Agroecology-Lab/Open_drive/bldc_motor_cntroller/images/Screenshot From 2026-01-03 15-03-06.png

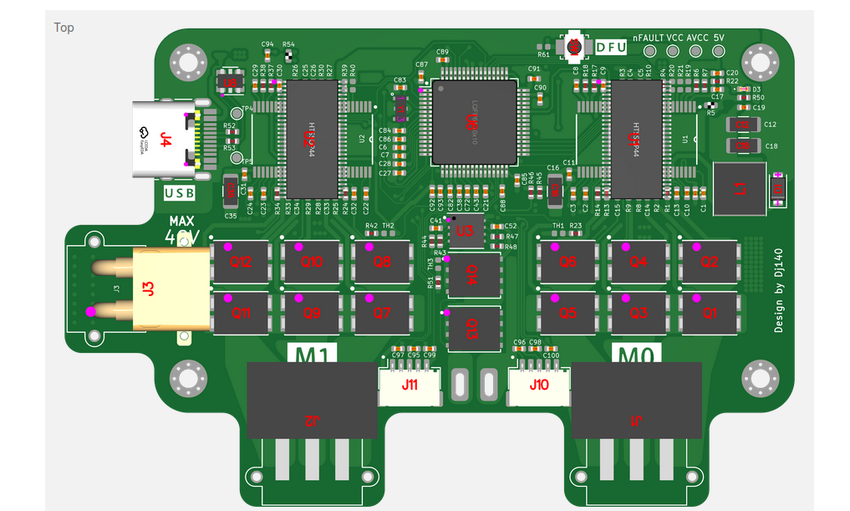
bldc_motor_cntroller/images/Screenshot From 2026-01-03 15-03-06.png
