Agroecology-Lab/Open_drive/bldc_motor_cntroller/images/Screenshot From 2026-10-24 23-25-10.png

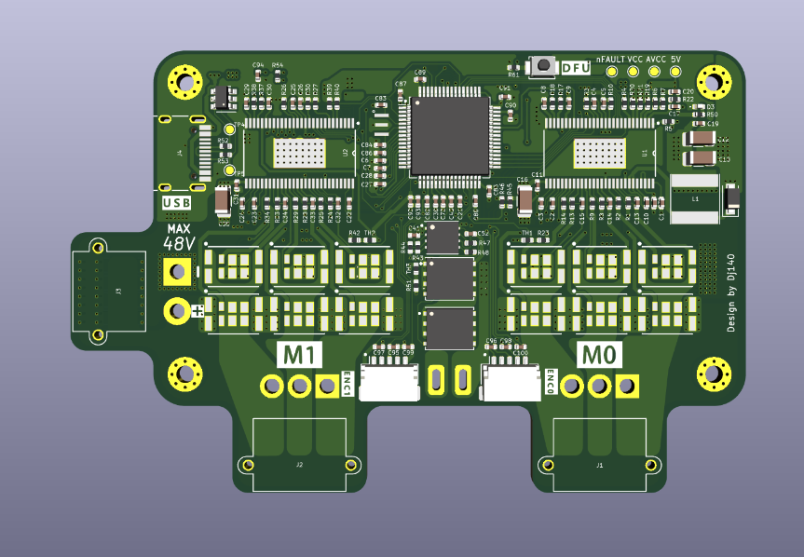
bldc_motor_cntroller/images/Screenshot From 2026-10-24 23-25-10.png
