Agroecology-Lab/Open_drive/bldc_motor_cntroller/production/Screenshot From 2026-01-03 14-52-30.png

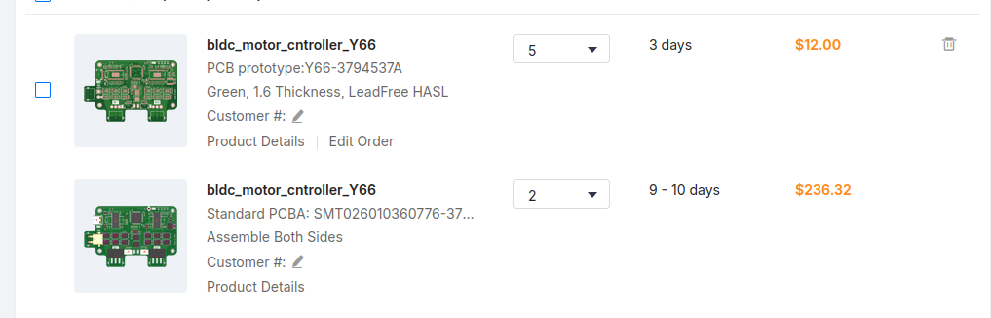
bldc_motor_cntroller/production/Screenshot From 2026-01-03 14-52-30.png
