Agroecology-Lab/Open_drive/bldc_motor_cntroller/production/bom_42v.csv

Comment | Designator | Footprint | LCSC Part #
15nF50V | C1,C22 | 0402 | C114405
2.2nF50V | C2,C3,C6,C7,C23,C24,C27,C28 | 0402 | C1531
22nF50V | C4,C25 | 0402 | C1532
2.2uF25VX5R | C5,C21,C26,C38,C41 | 0402 | C307418
1uF25V | C8,C9,C19,C29,C30,C49,C50,C58,C59,C93 | 0402 | C52923
100nF50V | C10,C13,C14,C15,C32,C33,C34,C52,C82,C85,C87,C89,C91,C92,C94,C95,C96,C97,C98,C99,C100 | 0402 | C131394
100nF100V | C11,C31,C36,C78,C79,C80,C81 | 0402 | C162178
47uF25VX5R | C12,C18 | 1206 | C76659
4.7uF100VX7R | C16,C35,C39,C40,C42,C44,C45,C46,C47,C48,C51,C53,C54,C55,C56,C57,C60,C61,C64,C65,C66,C67,C68,C69,C70,C71,C73,C74,C75,C76,C77 | 1206 | C22367839
82pF50VC0G | C17 | 0402 | C45501
270pF50V | C20,C43 | 0402 | C541471
0.1uF16V | C62,C63 | 0402 | C141382
2.2uF16VX5R | C72,C88,C90 | 0402 | C170151
12pF | C83,C84 | 0402 | C555399
100nF16V | C86 | 0402 | C60474
100V2ASMB | D1,D2 | D_SOD-123F | C705302
GREEN | D3 | 0402 | C74338
MBR2H100SFT3G | D4 | D_SOD-123F | C16197290
Fuse_500MA | F1 | 1206 | C2984676
MR30PW-M15A(30A) | J1,J2 | AMASS_MR30PW-M_1x03_P3.50mm_Horizontal | C19268034
XT30 | J3 | AMASS_XT30PW-M_1x02_P2.50mm_Horizontal | C431092
USB_C_Receptacle_USB2.0 | J4 | USB_C_Receptacle_HRO_TYPE-C-31-M-12 | C165948
Conn_01x03 | J5 | JST_SH_SM03B-SRSS-TB_1x03-1MP_P1.00mm_Horizontal | C5372879
Conn_01x06 | J6 | JST_SH_SM06B-SRSS-TB_1x06-1MP_P1.00mm_Horizontal | C160405
Conn_01x02 | J7,J8 | JST_SH_SM02B-SRSS-TB_1x02-1MP_P1.00mm_Horizontal | C160402
Conn_01x04 | J9 | JST_SH_SM04B-SRSS-TB_1x04-1MP_P1.00mm_Horizontal | C160404
Conn_01x05 | J10,J11 | JST_SH_SM05B-SRSS-TB_1x05-1MP_P1.00mm_Horizontal | C136657
33uH1.4A | L1 | L_Taiyo-Yuden_NR-60xx | C92942
IRF7580MTRPBF 60V | Q1,Q2,Q3,Q4,Q5,Q6,Q7,Q8,Q9,Q10,Q11,Q12 | MG-WDSON-8-05 (DirectFET ME) | C537819
CSD19532Q5B 100V | Q13,Q14 | TDSON-8-1 | C473333
2R2 | R1,R2,R8,R9,R13,R14,R24,R25,R28,R29,R33,R34,R47,R48 | 0402 | C25158
1k | R3,R26,R46,R50 | 0402 | C11702
18k1% | R4,R6,R27,R45 | 0402 | C25762
220k1% | R5 | 0402 | C25767
3.3k | R7,R10,R23,R30,R42,R43,R44,R51,R55,R56,R57,R58,R59,R60 | 0402 | C137992
120R1% | R11,R15,R31,R35,R54 | 0402 | C25079
500uOhm2W1% | R12,R16,R32,R36 | 2512 | C500611
22R1% | R17,R18,R37,R38,R52,R53 | 0402 | C25092
10k1% | R19,R20,R21,R39,R40,R61 | 0402 | C25744
47k1% | R22 | 0402 | C25792
B3U-1000P-B | SW1 | SW_SPST_B3U-1000P | C231329
NTC10k3380K | TH1,TH2,TH3 | 0402 | C77131
DRV8301DCAR | U1,U2 | DRV8301DCA | C98969
LM5109BSD | U3 | WSON-8_4x4mm_P0.8mm | C544701
SPX3819M5-L-3-3 | U4 | SOT-23-5 | C9055
LP5907MFX-3.3 | U5 | SOT-23-5 | C80670
STM32F405RGT7 | U6 | LQFP-64_10x10mm_P0.5mm | C1337199
SN65HVD232 | U7 | SOIC-8_3.9x4.9mm_P1.27mm | C177182
USBLC6-2SC6 | U8 | SOT-23-6 | C7519
Crystal_GND3_Small | Y1 | CSTCE8M00G55-R0 | C341522
