Agroecology-Lab/Open_drive/bldc_motor_cntroller/production/bom_final_v5-JLCPCB Assembly Order.xls

JLCPCB BOM Tool - BOM Matching
BOM name：bom_final_v5-JLCPCB Assembly Order.xlsx |  |  | Download Time：2026-10-25 17:17:17 |  |  |  | * Our matching results are updated in real-time, but stock and prices may change. If it's been over 24 hours, please re-match before placing your order.
PCB Assembled Qty：5 |  |  | Est. Total Price：142.4749
Your BOM |  |  |  | Matched Parts |  |  |  |  |  |  | Order Information
Designator | Comment | Footprint | JLCPCB Part # | Matches | Part # | Manufacturer | Footprint | Description | Category | Warning | JLCPCB Part # | Product link | Lib Type | Qty | Source | Total Price ($)
C1,C22 | 15nF50V | 0402 |  | Select by System | CC0402KRX7R9BB153 | YAGEO | 0402 | 15nF 50V X7R ±10% 0402 Multilayer Ceramic Capacitors MLCC - SMD/SMT ROHS | Multilayer Ceramic Capacitors MLCC - SMD/SMT |  | C114405 | https://jlcpcb.com/partdetail/YAGEO-CC0402KRX7R9BB153/C114405 | Extended | 20 | 20 JLCPCB | 0.068
C2,C3,C6,C7,C23,C24,C27,C28 | 2.2nF50V | 0402 |  | Select by System | 0402B222K500NT | FH (Guangdong Fenghua Advanced Tech) | 0402 | 2.2nF 50V X7R ±10% 0402 Multilayer Ceramic Capacitors MLCC - SMD/SMT ROHS | Multilayer Ceramic Capacitors MLCC - SMD/SMT |  | C1531 | https://jlcpcb.com/partdetail/1883-0402B222K500NT/C1531 | Extended | 26 | 26 JLCPCB | 0.065
C4,C25 | 22nF50V | 0402 |  | Select by System | 0402B223K500NT | FH (Guangdong Fenghua Advanced Tech) | 0402 | 22nF 50V X7R ±10% 0402 Multilayer Ceramic Capacitors MLCC - SMD/SMT ROHS | Multilayer Ceramic Capacitors MLCC - SMD/SMT |  | C1532 | https://jlcpcb.com/partdetail/1884-0402B223K500NT/C1532 | Basic | 20 | 20 JLCPCB | 0.098
C5,C21,C26,C38,C41 | 2.2uF25VX5R | 0402 |  | Select by System | CL05A225KA5NUNC | Samsung Electro-Mechanics | 0402 | 2.2uF 25V X5R ±10% 0402 Multilayer Ceramic Capacitors MLCC - SMD/SMT ROHS | Multilayer Ceramic Capacitors MLCC - SMD/SMT |  | C307418 | https://jlcpcb.com/partdetail/291092-CL05A225KA5NUNC/C307418 | Extended | 20 | 20 JLCPCB | 0.44
C8,C9,C19,C29,C30,C93,C49,C50,C58,C59 | 1uF25V | 0402 |  | Select by System | CL05A105KA5NQNC | Samsung Electro-Mechanics | 0402 | 1uF 25V X5R ±10% 0402 Multilayer Ceramic Capacitors MLCC - SMD/SMT ROHS | Multilayer Ceramic Capacitors MLCC - SMD/SMT |  | C52923 | https://jlcpcb.com/partdetail/53938-CL05A105KA5NQNC/C52923 | Basic | 42 | 42 JLCPCB | 0.2646
C10,C11,C13,C14,C15,C31,C36,C52,C78,C79,C80,C81 | 100nF50V | 0402 |  | Unconfirmed | CC0402KRX7R9BB104 | YAGEO | 0402 | 100nF 50V X7R ±10% 0402 Multilayer Ceramic Capacitors MLCC - SMD/SMT ROHS | Multilayer Ceramic Capacitors MLCC - SMD/SMT | 1.Multiple lines in the BOM have been matched to the same part. Please check if the matching is correct. ; | C131394 | https://jlcpcb.com/partdetail/YAGEO-CC0402KRX7R9BB104/C131394 | Extended | 80 | 80 JLCPCB | 0.848
C32,C33,C34 | 0.1uF50V | 0402 |  | Unconfirmed | CC0402KRX7R9BB104 | YAGEO | 0402 | 100nF 50V X7R ±10% 0402 Multilayer Ceramic Capacitors MLCC - SMD/SMT ROHS | Multilayer Ceramic Capacitors MLCC - SMD/SMT | 1.Multiple lines in the BOM have been matched to the same part. Please check if the matching is correct. ; | C131394 | https://jlcpcb.com/partdetail/YAGEO-CC0402KRX7R9BB104/C131394 | Extended | 80 | 80 JLCPCB | 0.848
C82,C85,C87,C89,C91,C92,C94,C95,C96,C97,C98,C99,C100 | 100nF | 0402 |  | Unconfirmed | CC0402KRX7R9BB104 | YAGEO | 0402 | 100nF 50V X7R ±10% 0402 Multilayer Ceramic Capacitors MLCC - SMD/SMT ROHS | Multilayer Ceramic Capacitors MLCC - SMD/SMT | 1.Multiple lines in the BOM have been matched to the same part. Please check if the matching is correct. ; | C131394 | https://jlcpcb.com/partdetail/YAGEO-CC0402KRX7R9BB104/C131394 | Extended | 80 | 80 JLCPCB | 0.848
C12,C18 | 47uF16V | 1206 |  | Select by System | C3216X5R1E476MTJ00E | TDK | 1206 | 25V 47uF X5R ±20% 1206 Multilayer Ceramic Capacitors MLCC - SMD/SMT ROHS | Multilayer Ceramic Capacitors MLCC - SMD/SMT |  | C76659 | https://jlcpcb.com/partdetail/TDK-C3216X5R1E476MTJ00E/C76659 | Extended | 5 | 5 JLCPCB | 2.733
C16,C35 | 4.7uF50V | 1206 |  | Select by System | CL31B475KBHNNNE | Samsung Electro-Mechanics | 1206 | 4.7uF 50V X7R ±10% 1206 Multilayer Ceramic Capacitors MLCC - SMD/SMT ROHS | Multilayer Ceramic Capacitors MLCC - SMD/SMT |  | C51205 | https://jlcpcb.com/partdetail/52218-CL31B475KBHNNNE/C51205 | Extended | 12 | 12 JLCPCB | 1.0452
C17 | 82pF50VC0G | 0402 |  | Select by System | 0402CG820J500NT | FH (Guangdong Fenghua Advanced Tech) | 0402 | 50V 82pF C0G ±5% 0402 Multilayer Ceramic Capacitors MLCC - SMD/SMT ROHS | Multilayer Ceramic Capacitors MLCC - SMD/SMT |  | C45501 | https://jlcpcb.com/partdetail/46503-0402CG820J500NT/C45501 | Extended | 20 | 20 JLCPCB | 0.056
C20,C43 | 270pF50V | 0402 |  | Select by System | CC0402FRNPO9BN271 | YAGEO | 0402 | 270pF 50V NP0 ±1% 0402 Multilayer Ceramic Capacitors MLCC - SMD/SMT ROHS | Multilayer Ceramic Capacitors MLCC - SMD/SMT |  | C541471 | https://jlcpcb.com/partdetail/YAGEO-CC0402FRNPO9BN271/C541471 | Extended | 20 | 20 JLCPCB | 0.116
C39,C40,C42,C44,C45,C46,C47,C48,C51,C53,C54,C55,C56,C57,C60,C61,C64,C65,C66,C67,C68,C69,C70,C71,C73,C74,C75,C76,C77 | 10uF50VX7R | 1206 |  | Select by System | CL31B106KBHNNNE | Samsung Electro-Mechanics | 1206 | 10uF 50V X7R ±10% 1206 Multilayer Ceramic Capacitors MLCC - SMD/SMT ROHS | Multilayer Ceramic Capacitors MLCC - SMD/SMT |  | C89632 | https://jlcpcb.com/partdetail/90812-CL31B106KBHNNNE/C89632 | Extended | 60 | 60 JLCPCB | 11.952
C62,C63 | 0.1uF16V | 0402 |  | Select by System | CT41G-0402-2X1-16V-0.1uF-K(N) | TORCH | 0402 | 100nF 16V ±10% 0402 Multilayer Ceramic Capacitors MLCC - SMD/SMT ROHS | Multilayer Ceramic Capacitors MLCC - SMD/SMT |  | C141382 | https://jlcpcb.com/partdetail/TORCH-CT41G_0402_2X1_16V_0_1uF_K_N/C141382 | Extended | 20 | 20 JLCPCB | 0.158
C72,C88,C90 | 2.2uF16VX5R | 0402 |  | Select by System | CL05A225KO5NQNC | Samsung Electro-Mechanics | 0402 | 16V 2.2uF X5R ±10% 0402 Multilayer Ceramic Capacitors MLCC - SMD/SMT ROHS | Multilayer Ceramic Capacitors MLCC - SMD/SMT |  | C170151 | https://jlcpcb.com/partdetail/181536-CL05A225KO5NQNC/C170151 | Extended | 20 | 20 JLCPCB | 0.4
C83,C84 | 12pF | 0402 |  | Select by System | 0402N120F500CT | Walsin Tech Corp | 0402 | 12pF 50V NP0 ±1% 0402 Multilayer Ceramic Capacitors MLCC - SMD/SMT ROHS | Multilayer Ceramic Capacitors MLCC - SMD/SMT |  | C555399 | https://jlcpcb.com/partdetail/Walsin_TechCorp-0402N120F500CT/C555399 | Extended | 20 | 20 JLCPCB | 0.206
C86 | 100nF16V | 0402 |  | Select by System | CC0402KRX7R7BB104 | YAGEO | 0402 | 100nF 16V X7R ±10% 0402 Multilayer Ceramic Capacitors MLCC - SMD/SMT ROHS | Multilayer Ceramic Capacitors MLCC - SMD/SMT |  | C60474 | https://jlcpcb.com/partdetail/YAGEO-CC0402KRX7R7BB104/C60474 | Extended | 22 | 22 JLCPCB | 0.1144
D1 | 100V2ASMB | D_SOD-123F |  | Select by System | SDM2100S1F-7 | Diodes Incorporated | SOD-123F | -55℃~+175℃ 1 Independent 100V 2A 35nA@100V 50A 780mV@2A SOD-123F Schottky Diodes ROHS | Schottky Diodes |  | C705302 | https://jlcpcb.com/partdetail/DiodesIncorporated-SDM2100S1F7/C705302 | Extended | 5 | 5 JLCPCB | 1.8675
D2 | MBR140SFT1G | D_SOD-123F |  | Select by Customer | MBR140SFT1G | onsemi | SOD-123FL | -55℃~+125℃ 1 Independent 1A 30A 40V 500uA@40V 550mV@1A SOD-123FL Schottky Diodes ROHS | Schottky Diodes |  | C43381 | https://jlcpcb.com/partdetail/onsemi-MBR140SFT1G/C43381 | Extended | 5 | 5 JLCPCB | 0.928
D3 | GREEN | 0402 |  | Select by System | 16-213/GHC-YR1S1/3T | Everlight Elec | 0402 | -40℃~+85℃ 110mW 120° 168.5mcd 20mA 3.3V 518nm 528nm Discrete Diode Green Water Clear 0402 LED Indication - Discrete ROHS | LED Indication - Discrete |  | C74338 | https://jlcpcb.com/partdetail/EverlightElec-16_213_GHC_YR1S13T/C74338 | Extended | 10 | 10 JLCPCB | 0.423
D4 | MBR2H100SFT3G | D_SOD-123F |  | Select by System | MBR2H100SFT3G-TP | TECH PUBLIC | SOD-123FL | -50℃~+150℃ 1 Independent 100V 2A 40uA@100V 50A 850mV@2A SOD-123FL Schottky Diodes ROHS | Schottky Diodes |  | C16197290 | https://jlcpcb.com/partdetail/TECHPUBLIC-MBR2H100SFT3GTP/C16197290 | Extended | 6 | 6 JLCPCB | 0.4746
F1 | Fuse_500MA | 1206 |  | Select by System | 500mA/24V | DOWO | 1206 | -40℃~+85℃ 150mΩ 1A 24V 40A 500mA 600mW 700mΩ 8s 1206 Resettable Fuses ROHS | Resettable Fuses |  | C2984676 | https://jlcpcb.com/partdetail/DOWO-500mA24V/C2984676 | Extended | 5 | 5 JLCPCB | 0.4505
J1,J2 | MR30PW-M15A(30A) | AMASS_MR30PW-M_1x03_P3.50mm_Horizontal |  | Select by System | MR30PW-M20.G.Y | Changzhou Amass Elec | - | - Power connector / plug connector ROHS | Plug |  | C19268034 | https://jlcpcb.com/partdetail/Changzhou_AmassElec-MR30PW_M20_GY/C19268034 | Extended | 4 | 4 JLCPCB | 2.0424
J3 | XT30 | AMASS_XT30PW-M_1x02_P2.50mm_Horizontal |  | Select by System | XT30PW-M30.G.Y | Changzhou Amass Elec | - | -、Aviation model plug 1.2mΩ 15A 16/18/20AWG 2pin DC 500V Male - Power connector / plug connector ROHS | Plug |  | C431092 | https://jlcpcb.com/partdetail/Changzhou_AmassElec-XT30PW_M30_GY/C431092 | Extended | 2 | 2 JLCPCB | 0.7692
J4 | USB_C_Receptacle_USB2.0 | USB_C_Receptacle_HRO_TYPE-C-31-M-12 |  | Select by System | TYPE-C-31-M-12 | Korean Hroparts Elec | SMD | -30℃~+80℃ 1 10,000 cycles 16P 20V 5A 7.35mm Female Surface Mount, Right Angle Type-C SMD USB Connectors ROHS | USB Connectors |  | C165948 | https://jlcpcb.com/partdetail/Korean_HropartsElec-TYPE_C_31_M12/C165948 | Extended | 2 | 2 JLCPCB | 0.3738
J5 | Conn_01x03 | JST_SH_SM03B-SRSS-TB_1x03-1MP_P1.00mm_Horizontal |  | Select by Customer | HC-1.0-3PWT-B | HCTL | SMD,P=1mm,卧贴 | -25℃~+85℃ 1 1A 1mm 1x3P 3 3.2mm 3P 5.05mm 5.3mm 50V Auxiliary Solder Pin LCP Phosphor bronze SH Surface Mount, Right Angle Tin UL94V-0 SMD,P=1mm,Surface Mount，Right Angle Wire To Board Connector ROHS | Wire To Board Connector |  | C5372879 | https://jlcpcb.com/partdetail/HCTL-HC_1_0_3PWTB/C5372879 | Extended | 5 | 5 JLCPCB | 0.3005
J6 | Conn_01x06 | JST_SH_SM06B-SRSS-TB_1x06-1MP_P1.00mm_Horizontal |  | Select by System | SM06B-SRSS-TB(LF)(SN) | JST | SMD,P=1mm,卧贴 | -25℃~+85℃ 1 1A 1mm 1x6P 2.9mm 4.32mm 50V 6 6P 8mm Auxiliary Solder Pin Copper alloy PA SH Surface Mount, Right Angle Tin UL94V-0 White SMD,P=1mm,Surface Mount，Right Angle Wire To Board Connector ROHS | Wire To Board Connector |  | C160405 | https://jlcpcb.com/partdetail/JST-SM06B_SRSS_TB_LF_SN/C160405 | Extended | 2 | 2 JLCPCB | 1.7936
J7,J8 | Conn_01x02 | JST_SH_SM02B-SRSS-TB_1x02-1MP_P1.00mm_Horizontal |  | Select by System | SM02B-SRSS-TB(LF)(SN) | JST | SMD,P=1mm,卧贴 | -25℃~+85℃ 1 1A 1mm 1x2P 2 2.9mm 2P 4.32mm 4mm 50V Auxiliary Solder Pin Copper alloy PA SH Surface Mount, Right Angle Tin UL94V-0 White SMD,P=1mm,卧贴 Wire To Board Connector ROHS | Wire To Board Connector |  | C160402 | https://jlcpcb.com/partdetail/JST-SM02B_SRSS_TB_LF_SN/C160402 | Extended | 8 | 8 JLCPCB | 1.0584
J9 | Conn_01x04 | JST_SH_SM04B-SRSS-TB_1x04-1MP_P1.00mm_Horizontal |  | Select by System | SM04B-SRSS-TB(LF)(SN) | JST | SMD,P=1mm,卧贴 | -25℃~+85℃ 1 1A 1mm 1x4P 2.9mm 4 4.32mm 4P 50V 6mm Auxiliary Solder Pin Copper alloy PA SH Surface Mount, Right Angle Tin UL94V-0 White SMD,P=1mm,卧贴 Wire To Board Connector ROHS | Wire To Board Connector |  | C160404 | https://jlcpcb.com/partdetail/JST-SM04B_SRSS_TB_LF_SN/C160404 | Extended | 5 | 5 JLCPCB | 1.074
J10,J11 | Conn_01x05 | JST_SH_SM05B-SRSS-TB_1x05-1MP_P1.00mm_Horizontal |  | Select by System | SM05B-SRSS-TB(LF)(SN) | JST | SMD,P=1mm,卧贴 | -25℃~+85℃ 1 1A 1mm 1x5P 2.9mm 4.32mm 5 50V 5P 7mm Auxiliary Solder Pin Copper alloy PA SH Surface Mount, Right Angle Tin UL94V-0 White SMD,P=1mm,卧贴 Wire To Board Connector ROHS | Wire To Board Connector |  | C136657 | https://jlcpcb.com/partdetail/JST-SM05B_SRSS_TB_LF_SN/C136657 | Extended | 5 | 5 JLCPCB | 2.8475
L1 | 33uH1.4A | L_Taiyo-Yuden_NR-60xx |  | Select by System | NR6045T330M | Taiyo Yuden | SMD,6x6mm | 1.4A 1.5A 188.5mΩ 33uH ±20% SMD,6x6mm Power Inductors ROHS | Power Inductors |  | C92942 | https://jlcpcb.com/partdetail/TaiyoYuden-NR6045T330M/C92942 | Extended | 3 | 3 JLCPCB | 2.4894
Q1,Q2,Q3,Q4,Q5,Q6,Q7,Q8,Q9,Q10,Q11,Q12 | IRF7480MTRPBF | Infineon-MG-WDSON-8-05_2016-901-MFG |  | Select by System | IRF7480MTRPBF | Infineon Technologies | DirectFET | -55℃~+150℃ 1 N-channel 1.035nF 1.6mΩ@6V 123nC@10V 3.9V 330A 40V 96W N-Channel DirectFET MOSFETs ROHS | MOSFETs |  | C152356 | https://jlcpcb.com/partdetail/InfineonTechnologies-IRF7480MTRPBF/C152356 | Extended | 24 | 24 JLCPCB | 20.1096
Q13,Q14 | CSD18540Q5B | TDSON-8-1 |  | Select by System | CSD18540Q5B | Texas Instruments | VSON-8(5x6) | -55℃~+175℃ 1 N-channel 1.9V 2.6mΩ 205A 20pF 3.8W 4.23nF 41nC@10V 60V 808pF N-Channel VSON-8(5x6) MOSFETs ROHS | MOSFETs |  | C86513 | https://jlcpcb.com/partdetail/TexasInstruments-CSD18540Q5B/C86513 | Extended | 4 | 4 JLCPCB | 10.022
R1,R2,R8,R9,R13,R14,R24,R25,R28,R29,R33,R34,R47,R48 | 2R2 | 0402 |  | Select by System | 0402WGJ022JTCE | UNI-ROYAL(Uniroyal Elec) | 0402 | -55℃~+155℃ 2.2Ω 50V 62.5mW Thick Film Resistor ±200ppm/℃ ±5% 0402 Chip Resistor - Surface Mount ROHS | Chip Resistor - Surface Mount |  | C25158 | https://jlcpcb.com/partdetail/25901-0402WGJ022JTCE/C25158 | Extended | 38 | 38 JLCPCB | 0.0494
R3,R26,R46,R50 | 1k | 0402 |  | Select by System | 0402WGF1001TCE | UNI-ROYAL(Uniroyal Elec) | 0402 | -55℃~+155℃ 1kΩ 50V 62.5mW Thick Film Resistor ±1% ±100ppm/℃ 0402 Chip Resistor - Surface Mount ROHS | Chip Resistor - Surface Mount |  | C11702 | https://jlcpcb.com/partdetail/12256-0402WGF1001TCE/C11702 | Basic | 20 | 20 JLCPCB | 0.026
R4,R6,R27,R45 | 18k1% | 0402 |  | Select by System | 0402WGF1802TCE | UNI-ROYAL(Uniroyal Elec) | 0402 | -55℃~+155℃ 18kΩ 50V 62.5mW Thick Film Resistor ±1% ±100ppm/℃ 0402 Chip Resistor - Surface Mount ROHS | Chip Resistor - Surface Mount |  | C25762 | https://jlcpcb.com/partdetail/26505-0402WGF1802TCE/C25762 | Extended | 20 | 20 JLCPCB | 0.026
R5 | 220k1% | 0402 |  | Select by System | 0402WGF2203TCE | UNI-ROYAL(Uniroyal Elec) | 0402 | -55℃~+155℃ 220kΩ 50V 62.5mW Thick Film Resistor ±1% ±100ppm/℃ 0402 Chip Resistor - Surface Mount ROHS | Chip Resistor - Surface Mount |  | C25767 | https://jlcpcb.com/partdetail/26510-0402WGF2203TCE/C25767 | Extended | 20 | 20 JLCPCB | 0.026
R7,R10,R23,R30,R42,R43,R44,R51,R55,R56,R57,R58,R59,R60 | 3.3k | 0402 |  | Select by System | RC0402FR-073K3L | YAGEO | 0402 | -55℃~+155℃ 3.3kΩ 50V 62.5mW Thick Film Resistor ±1% ±100ppm/℃ 0402 Chip Resistor - Surface Mount ROHS | Chip Resistor - Surface Mount |  | C137992 | https://jlcpcb.com/partdetail/YAGEO-RC0402FR073K3L/C137992 | Extended | 52 | 52 JLCPCB | 0.1768
R12,R16,R32,R36 | 500uOhm2W1% | 2512 |  | Select by System | LR2512D-2W-0.5mR-1% | Milliohm | 2512 | 0.5mΩ 25ppm/℃~+50ppm/℃ 2W Current Sense Resistor SMD ±1% 2512 Current Sense Resistors / Shunt Resistors ROHS | Current Sense Resistors / Shunt Resistors |  | C500611 | https://jlcpcb.com/partdetail/Milliohm-LR2512D_2W_0_5mR_1/C500611 | Extended | 10 | 10 JLCPCB | 1.198
R17,R18,R37,R38,R52,R53 | 22R1% | 0402 |  | Select by System | 0402WGF220JTCE | UNI-ROYAL(Uniroyal Elec) | 0402 | -55℃~+155℃ 22Ω 50V 62.5mW Thick Film Resistor ±1% ±100ppm/℃ 0402 Chip Resistor - Surface Mount ROHS | Chip Resistor - Surface Mount |  | C25092 | https://jlcpcb.com/partdetail/25835-0402WGF220JTCE/C25092 | Basic | 22 | 22 JLCPCB | 0.0308
R19,R20,R21,R39,R40,R61 | 10k1% | 0402 |  | Select by System | 0402WGF1002TCE | UNI-ROYAL(Uniroyal Elec) | 0402 | -55℃~+155℃ 10kΩ 50V 62.5mW Thick Film Resistor ±1% ±100ppm/℃ 0402 Chip Resistor - Surface Mount ROHS | Chip Resistor - Surface Mount |  | C25744 | https://jlcpcb.com/partdetail/26487-0402WGF1002TCE/C25744 | Basic | 22 | 22 JLCPCB | 0.0242
R22 | 47k1% | 0402 |  | Select by System | 0402WGF4702TCE | UNI-ROYAL(Uniroyal Elec) | 0402 | -55℃~+155℃ 47kΩ 50V 62.5mW Thick Film Resistor ±1% ±100ppm/℃ 0402 Chip Resistor - Surface Mount ROHS | Chip Resistor - Surface Mount |  | C25792 | https://jlcpcb.com/partdetail/26535-0402WGF4702TCE/C25792 | Basic | 20 | 20 JLCPCB | 0.04
R54,R11,R15,R31,R35 | 120R1% | 0402 |  | Select by System | 0402WGF1200TCE | UNI-ROYAL(Uniroyal Elec) | 0402 | -55℃~+155℃ 120Ω 50V 62.5mW Thick Film Resistor ±1% ±100ppm/℃ 0402 Chip Resistor - Surface Mount ROHS | Chip Resistor - Surface Mount |  | C25079 | https://jlcpcb.com/partdetail/25822-0402WGF1200TCE/C25079 | Basic | 40 | 40 JLCPCB | 0.136
SW1 | B3U-1000P-B | SW_SPST_B3U-1000P |  | Select by System | B3U-1000P | Omron Electronics | SMD,3x2.5mm | -25℃~+70℃ 1.53N 1.6mm 12V 2.5mm 3mm 50mA Round Button SMD(SMT) Tab SPST Surface Mount,Vertical SMD,3x2.5mm Tactile Switches ROHS | Tactile Switches |  | C231329 | https://jlcpcb.com/partdetail/OmronElectronics-B3U1000P/C231329 | Extended | 5 | 5 JLCPCB | 0.939
TH1,TH2,TH3 | NTC10k3380K | 0402 |  | Select by System | NCP15XH103F03RC | Murata Electronics | 0402 | -40℃~+125℃ 0.5mm 100mW 10kΩ 1mW/℃ 1mm 310uA 3380K 3434K 3455K ±1% ±1% 0402 NTC Thermistors ROHS | NTC Thermistors |  | C77131 | https://jlcpcb.com/partdetail/MurataElectronics-NCP15XH103F03RC/C77131 | Extended | 20 | 20 JLCPCB | 0.388
U1,U2 | DRV8301DCAR | DRV8301DCA |  | Select by System | DRV8301DCAR | Texas Instruments | HTSSOP-56-6mm | -40℃~+125℃ 1.7A 2.3A 20uA 25ns 25ns 6 6V~60V MOSFET Three Phase Under Voltage Protection、Over Voltage Protection、Over Current Protection、Overtemperature protection (OTP) HTSSOP-56-6mm Gate Drivers ROHS | Brushless DC (BLDC) Motor Driver |  | C98969 | https://jlcpcb.com/partdetail/TexasInstruments-DRV8301DCAR/C98969 | Extended | 4 | 4 JLCPCB | 17.5236
U3 | LM5109BSD | WSON-8_4x4mm_P0.8mm |  | Select by System | LM5109BSD/NOPB | Texas Instruments | WSON-8-EP(4x4) | -40℃~+125℃ 1.8V 1.8V 15ns 15ns 1A 1A 2 300uA 30ns 32ns 8V~14V Half-Bridge MOSFET Under Voltage Protection WSON-8-EP(4x4) Gate Drivers ROHS | Gate Drivers |  | C544701 | https://jlcpcb.com/partdetail/TexasInstruments-LM5109BSDNOPB/C544701 | Extended | 2 | 2 JLCPCB | 3.7542
U4 | SPX3819M5-L-3-3 | SOT-23-5 |  | Select by System | SPX3819M5-L-3-3/TR | MaxLinear | SOT-23-5 | -40℃~+125℃ 1 16V 3.3V 340mV@(500mA) 40uVrms 500mA 70dB 90uA Fixed Over Current Protection、Over Temperature Protection、Enable Positive SOT-23-5 Voltage Regulators - Linear, Low Drop Out (LDO) Regulators ROHS | Voltage Regulators - Linear, Low Drop Out (LDO) Regulators |  | C9055 | https://jlcpcb.com/partdetail/MaxLinear-SPX3819M5_L_3_3TR/C9055 | Extended | 5 | 5 JLCPCB | 1.4005
U5 | LP5907MFX-3.3 | SOT-23-5 |  | Select by System | LP5907MFX-3.3/NOPB | Texas Instruments | SOT-23-5 | -40℃~+125℃@(Tj) 1 10uVrms 12uA 250mA 250mV@(250mA) 3.3V 5.5V 82dB@(1kHz) Fixed Positive Short Circuit Protection、Thermal shutdown、Enable control、Input under-voltage protection、Output discharge SOT-23-5 Voltage Regulators - Linear, Low Drop Out (LDO) Regulators ROHS | Voltage Regulators - Linear, Low Drop Out (LDO) Regulators |  | C80670 | https://jlcpcb.com/partdetail/TexasInstruments-LP5907MFX_3_3NOPB/C80670 | Extended | 5 | 5 JLCPCB | 0.825
U6 | STM32F405RGT7 | LQFP-64_10x10mm_P0.5mm |  | Select by System | STM32F405RGT7 | STMicroelectronics | LQFP-64(10x10) | -40℃~+105℃ 1.8V~3.6V 12bit 12bit 168MHz 192KB 1MB 32 Bit 51 ARM Cortex-M4 Built-in FLASH LQFP-64(10x10) Microcontrollers (MCU/MPU/SOC) ROHS | Microcontrollers (MCU/MPU/SOC) |  | C1337199 | https://jlcpcb.com/partdetail/STMicroelectronics-STM32F405RGT7/C1337199 | Extended | 2 | 2 JLCPCB | 41.2134
U7 | SN65HVD232 | SOIC-8_3.9x4.9mm_P1.27mm |  | Select by System | SN65HVD232QDR | Texas Instruments | SOIC-8 | -40℃~+125℃ 10mA 1Mbps 3V~3.6V CAN Transceiver SOIC-8 CAN Transceivers ROHS | CAN Transceivers |  | C177182 | https://jlcpcb.com/partdetail/TexasInstruments-SN65HVD232QDR/C177182 | Extended | 2 | 2 JLCPCB | 5.4988
U8 | USBLC6-2SC6 | SOT-23-6 |  | Select by System | USBLC6-2SC6 | STMicroelectronics | SOT-23-6L | -40℃~+125℃ 150nA 17V 2 3.5pF 5.25V 5A 6V ESD IEC 61000-4-2 Unidirectional SOT-23-6L ESD and Surge Protection (TVS/ESD) ROHS | ESD And Surge Protection (TVS/ESD) |  | C7519 | https://jlcpcb.com/partdetail/STMicroelectronics-USBLC62SC6/C7519 | Extended | 5 | 5 JLCPCB | 0.8985
Y1 | Crystal_GND3_Small | CSTCE8M00G55-R0 |  | Select by System | CSTNE8M00G550000R0 | Murata Electronics | SMD3213-3P | -40℃~+85℃ 33pF 40Ω 8MHz SMD3213-3P Ceramic Resonators ROHS | Ceramic Resonators |  | C341522 | https://jlcpcb.com/partdetail/318914-CSTNE8M00G550000R0/C341522 | Extended | 5 | 5 JLCPCB | 1.0165
H5,H6 | MountingHole_Pad | TestPoint_Round |  | No matches | No Part Selected
