Agroecology-Lab/Open_drive/Open_Drive_Schematic.pdf

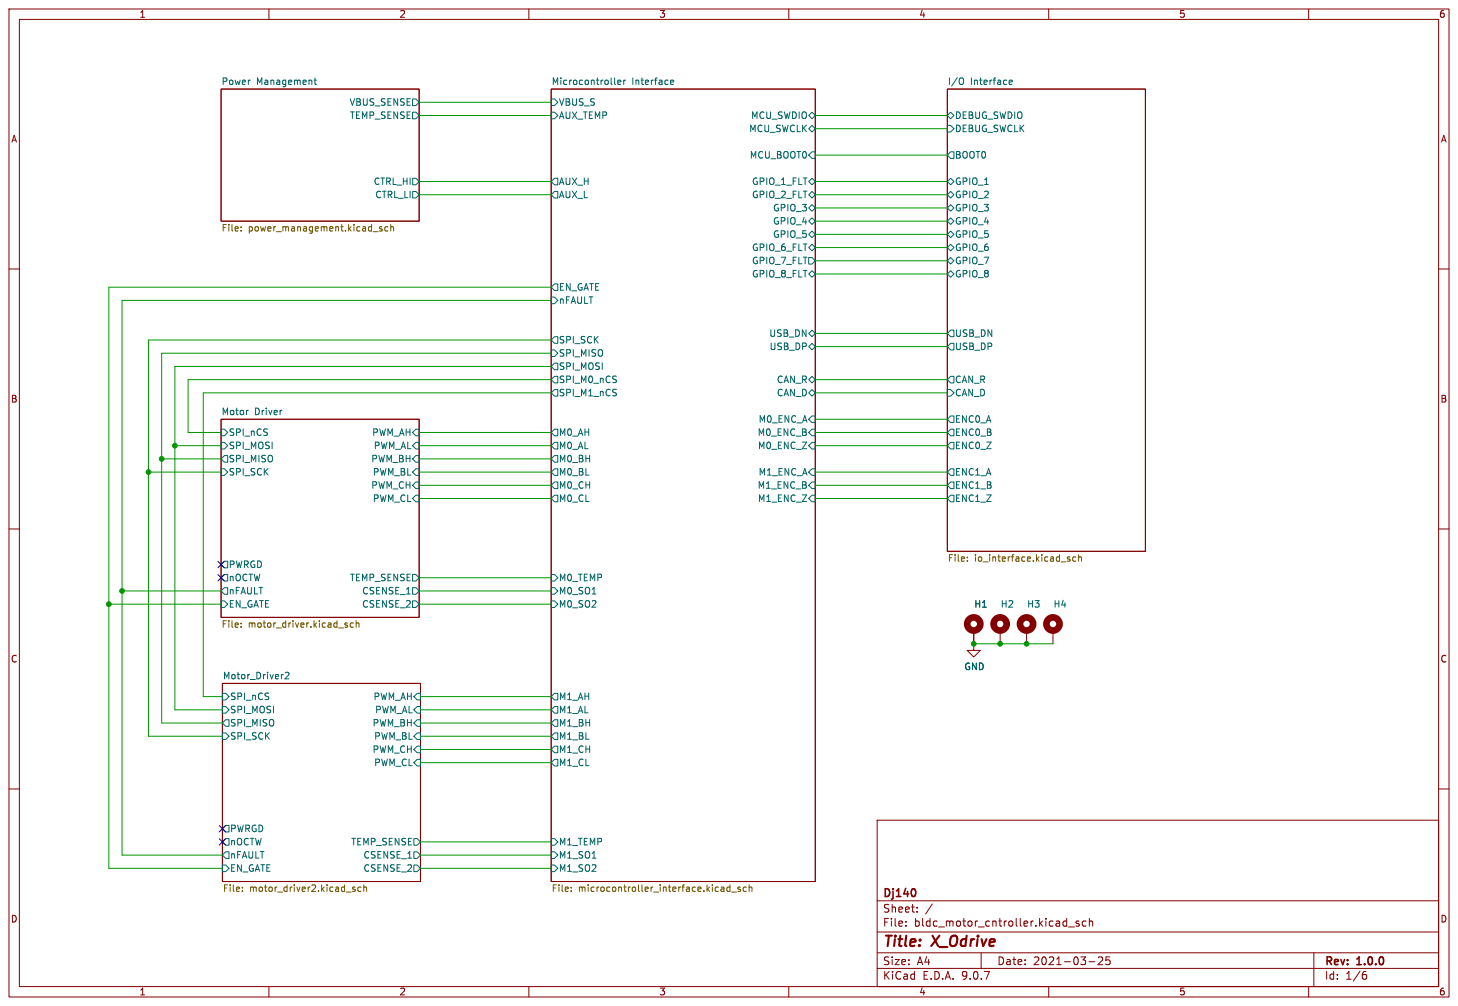
[picture p7: page 1]

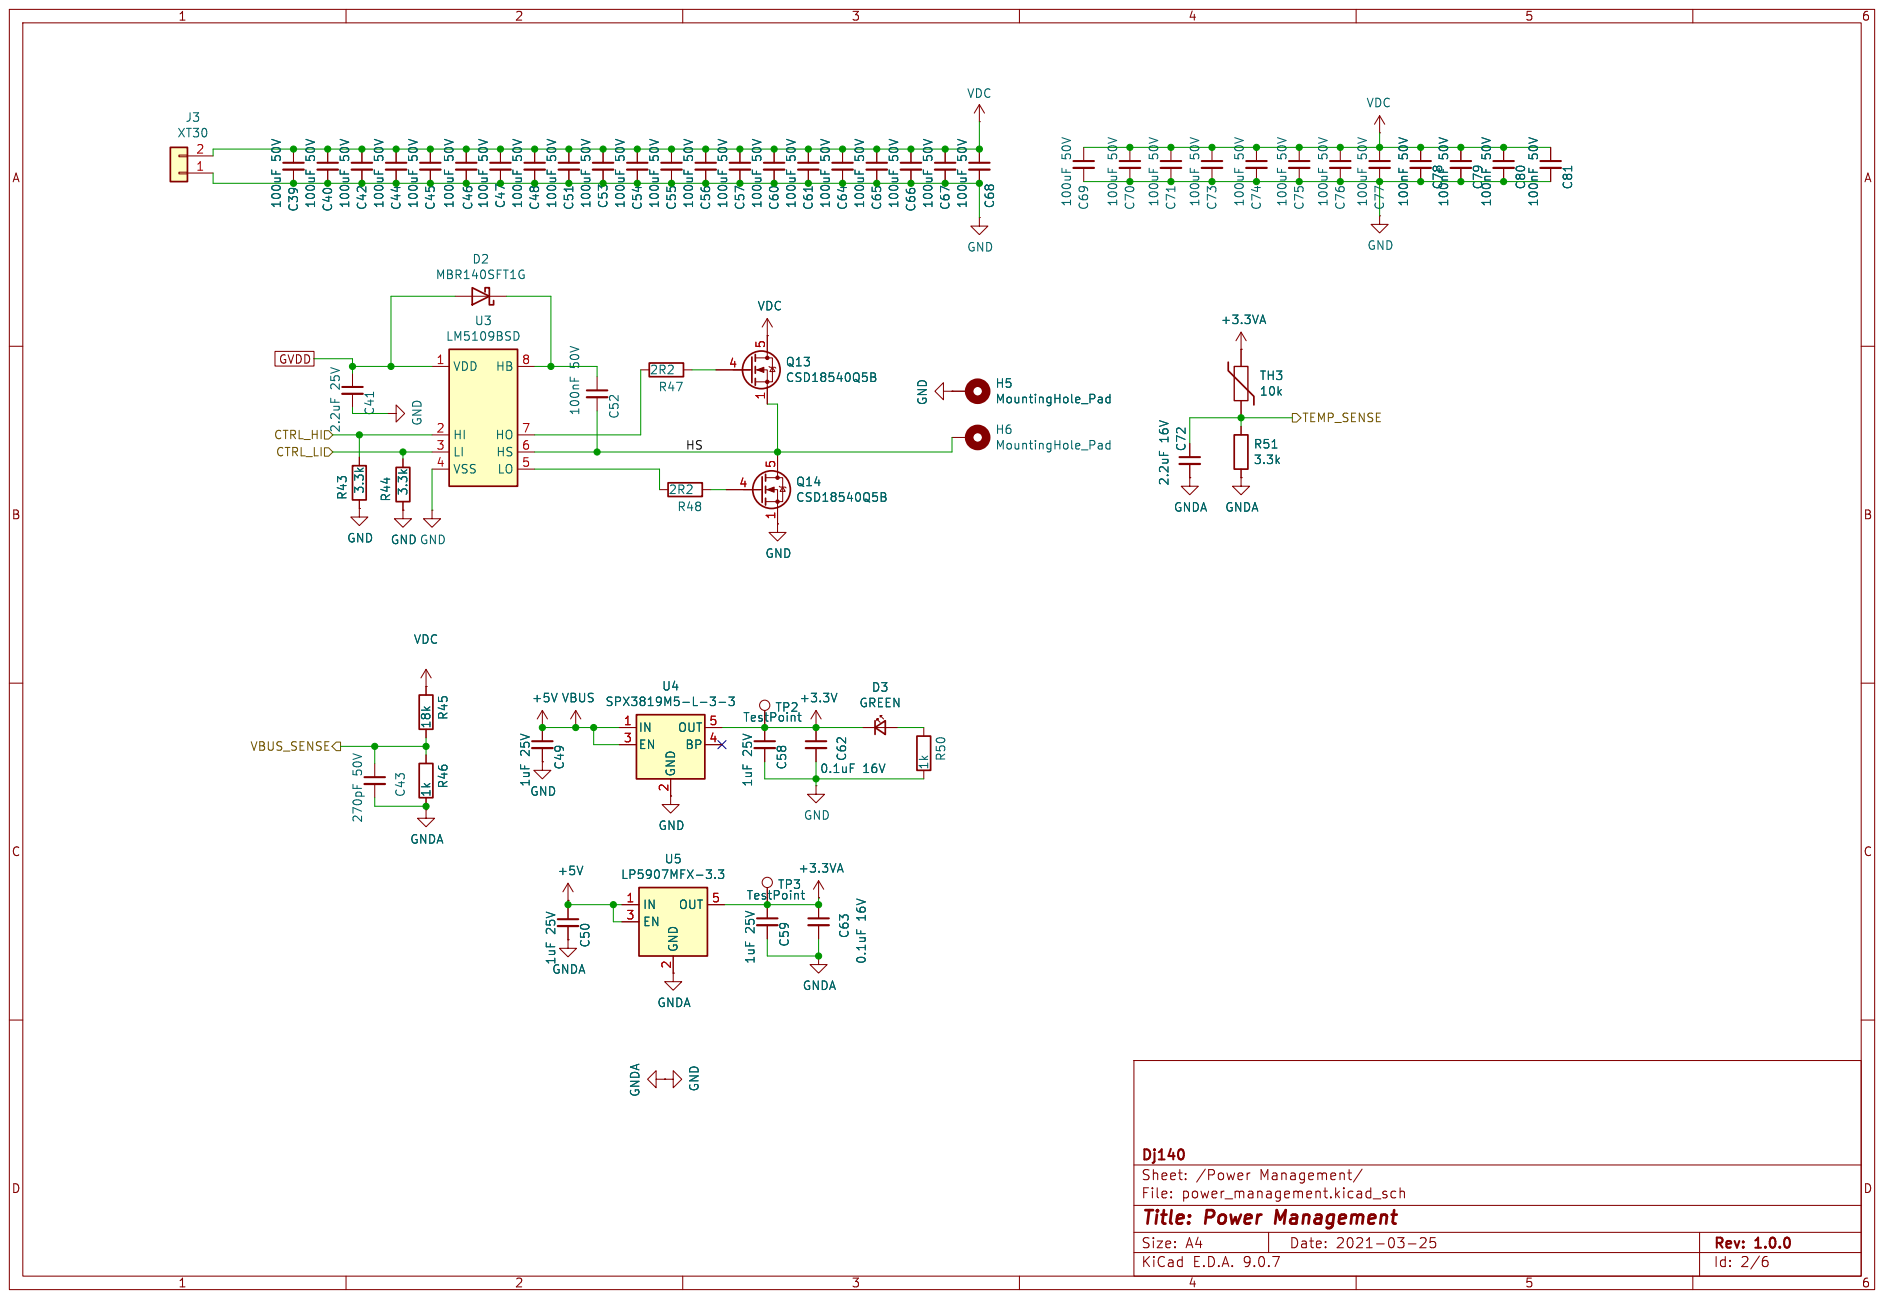
[picture p8: page 2]

2 OUT 5 BP 4 GND C49 1uF 25V +5V VBUS R45 18k VDC R43 3.3k R44 3.3k GND GND 100uF C47 50V 100uF C46 50V 100uF C45 50V 100uF C44 50V C39 100uF 50V C40 100uF 50V 100uF C42 50V GNDA C59 1uF 25V GNDA GND C50 1uF 25V +5V GNDA

2 OUT 5 BP 4 U4 SPX3819M5-L-3-3 C43 270pF 50V C52 100nF 50V GNDA C59 1uF 25V GNDA GND 100uF C54 50V 100uF C53 50V C81 100nF 50V

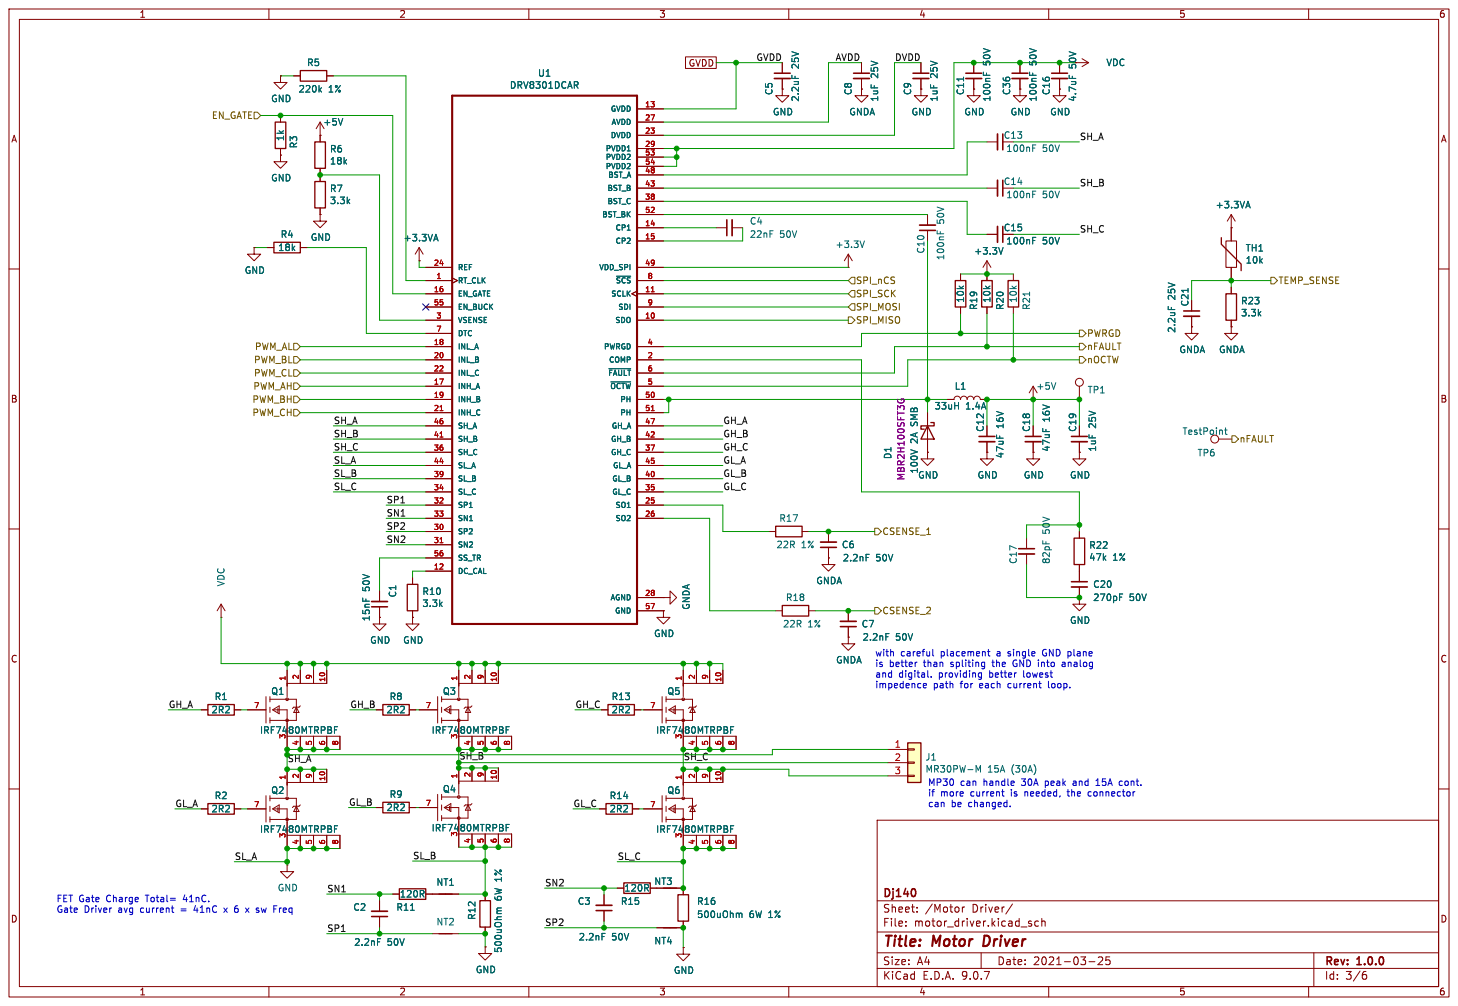
[picture p9: page 3]

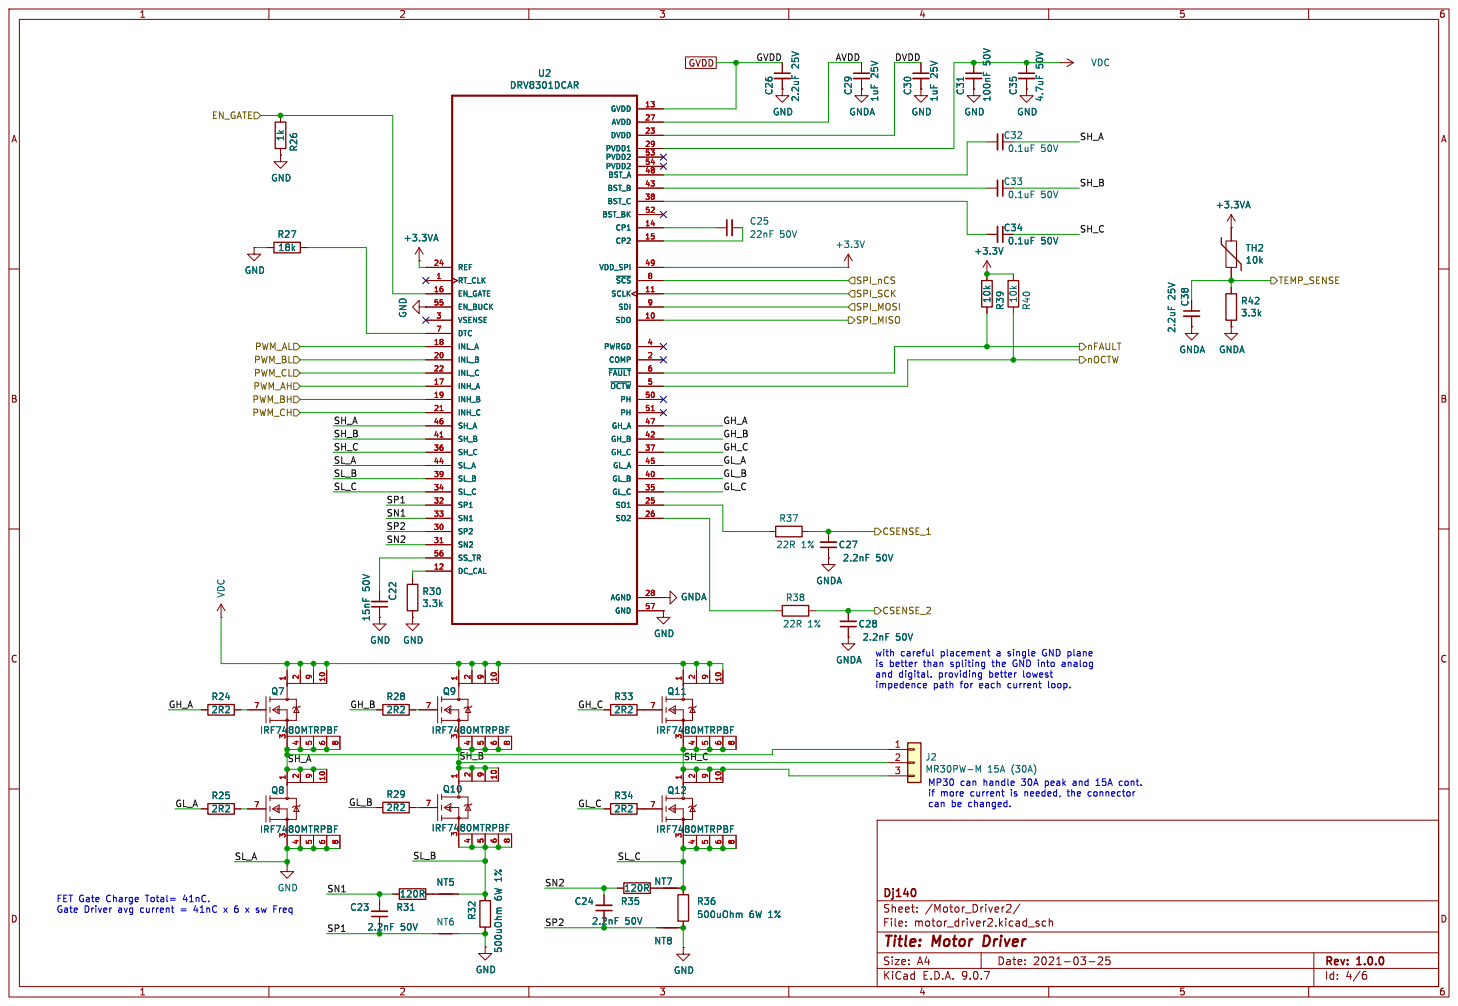
[picture p10: page 4]

Id: 4/6 Title: Motor Driver File: motor_driver2.kicad_sch Sheet: /Motor_Driver2/

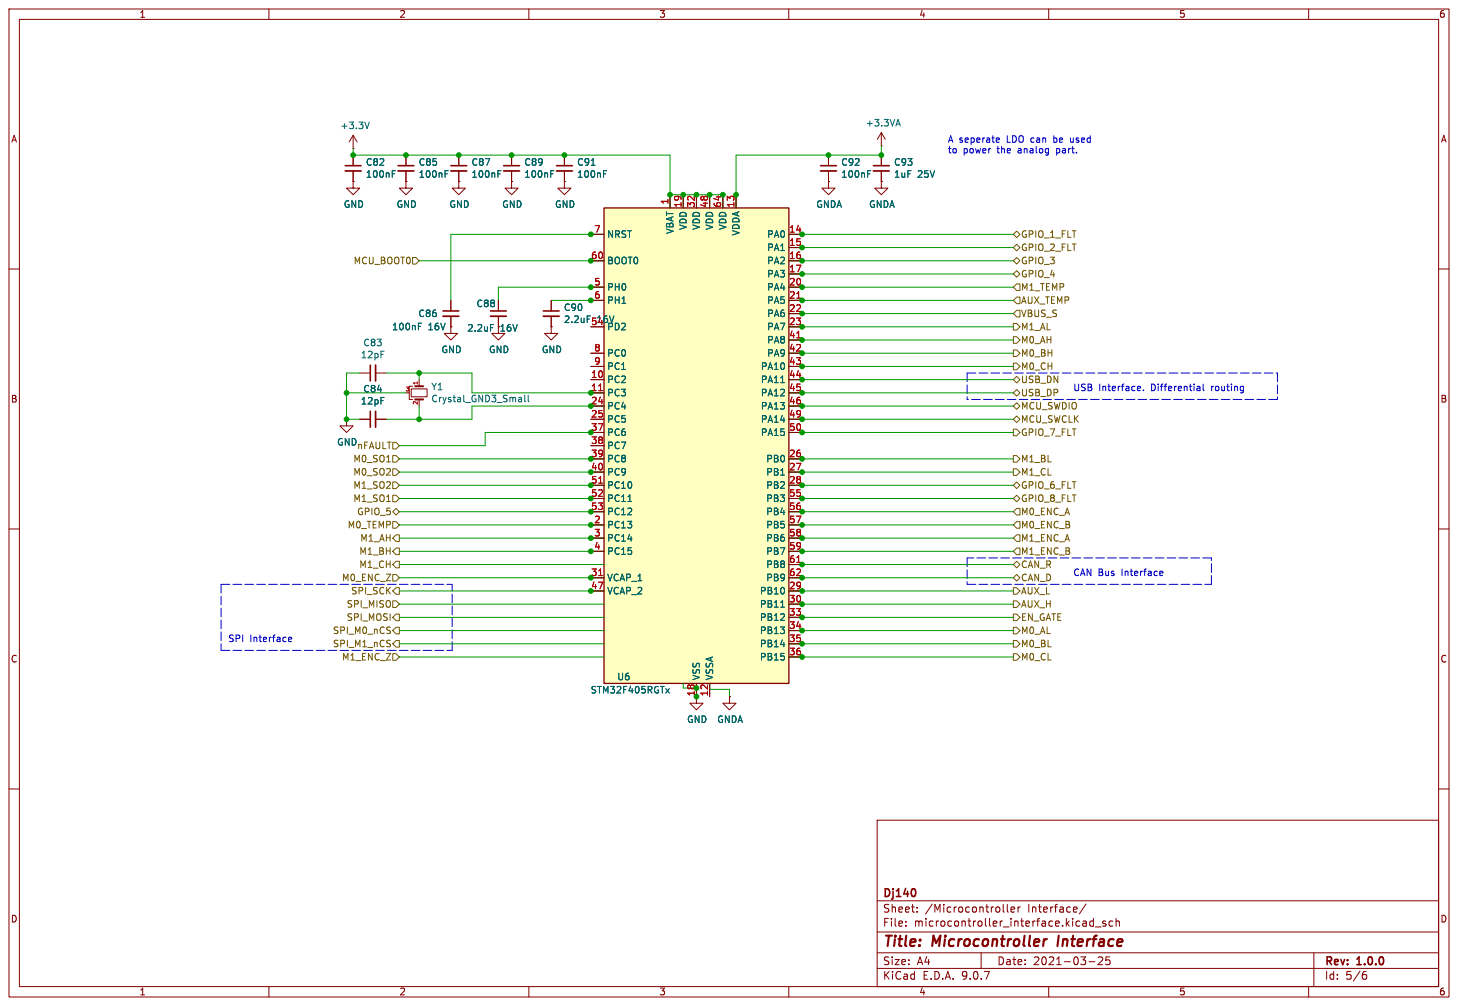
[picture p11: page 5]

to power the analog part.CAN Bus Interface SPI Interface

1 VDD 19 VDD 32 VSS 18 VDD 48 VSSA 12 VDD 64 VDDA 13 PA0 14 PA1 15 PA2 16 PA3 17 PA4 20 PA5 21 PA6 22 PA7 23 PA8 41 PA9 42 PA10 43 PA11 44 PA12 45 PA13 46 PA14 49 PA15 50 PB0 26 PB1 27 PB2 28 PB3 55 PB4 56 PB5 57 PB6 58 PB7 59 PB8 61 PB9 62 PB10 29 PB11 30 PB12 33 PB13 34 PB14 35 PB15 36 GND

1 VDD 19 VDD 32 VSS 18 VDD 48 VSSA 12 VDD 64 VDDA 13 PA0 14 PA1 15 PA2 16 PA3 17 PA4 20 PA5 21 PA6 22 PA7 23 PA8 41 PA9 42 PA10 43 PA11 44 PA12 45 PA13 46 PA14 49 PA15 50 PB0 26 PB1 27 PB2 28 PB3 55 PB4 56 PB5 57 PB6 58 PB7 59 PB8 61 PB9 62 PB10 29 PB11 30 PB12 33 PB13 34 PB14 35 PB15 36 U6 STM32F405RGTx GND

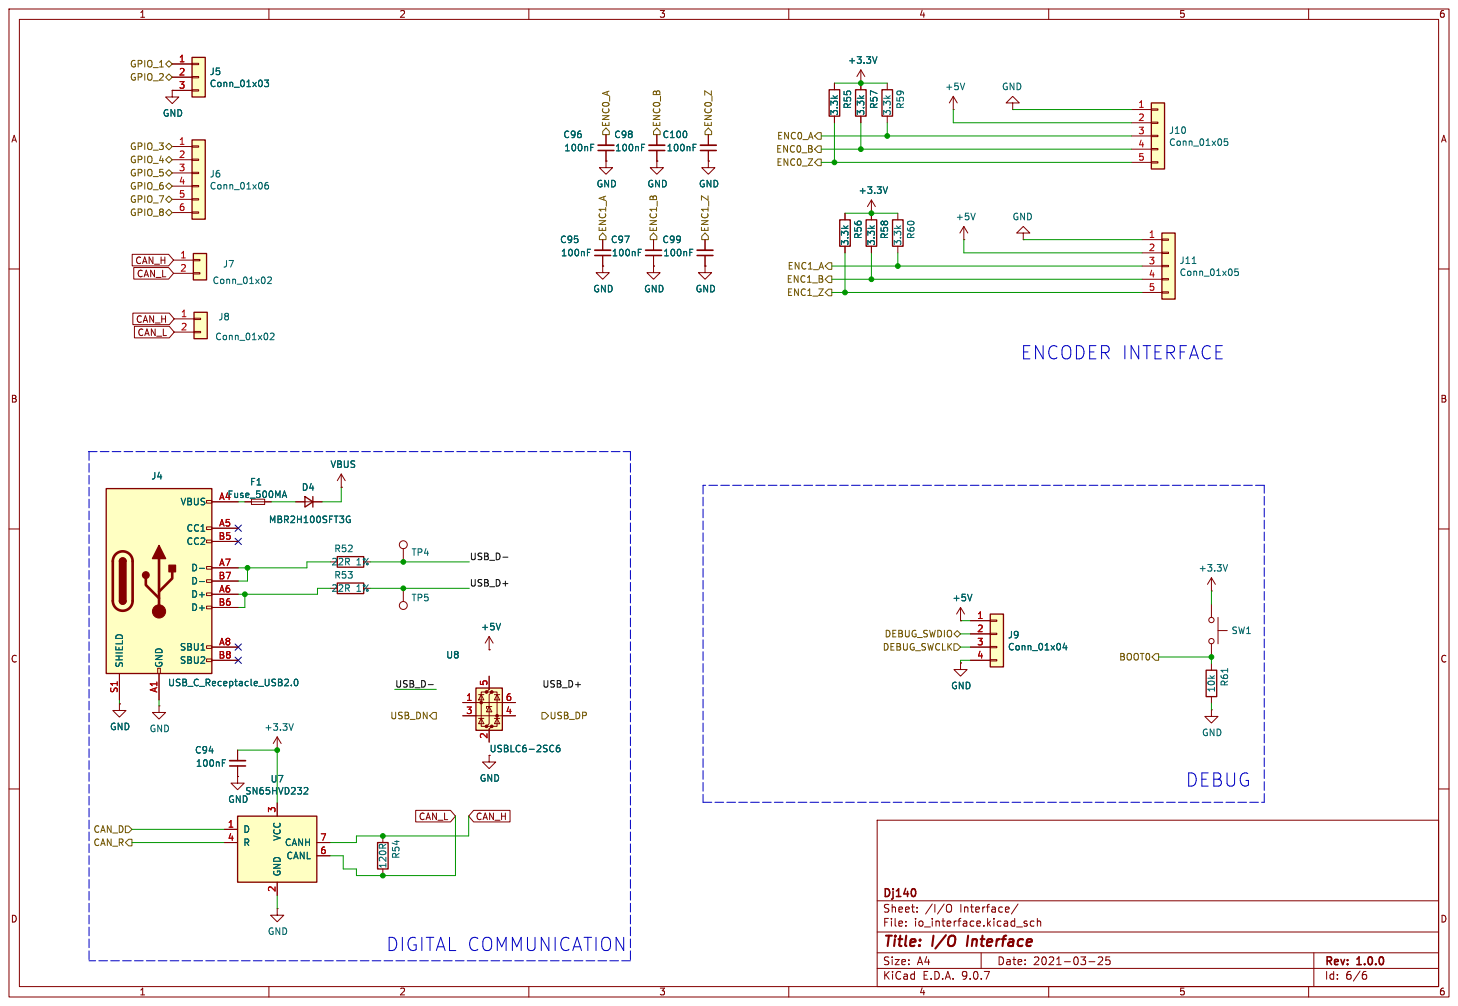
[picture p12: page 6]
