Agroecology-Lab/Open_drive/bldc_motor_cntroller/bldc_motor_cntroller.kicad_pcb

## KiCad design bldc_motor_cntroller/bldc_motor_cntroller.kicad_pcb (2026-10-25)

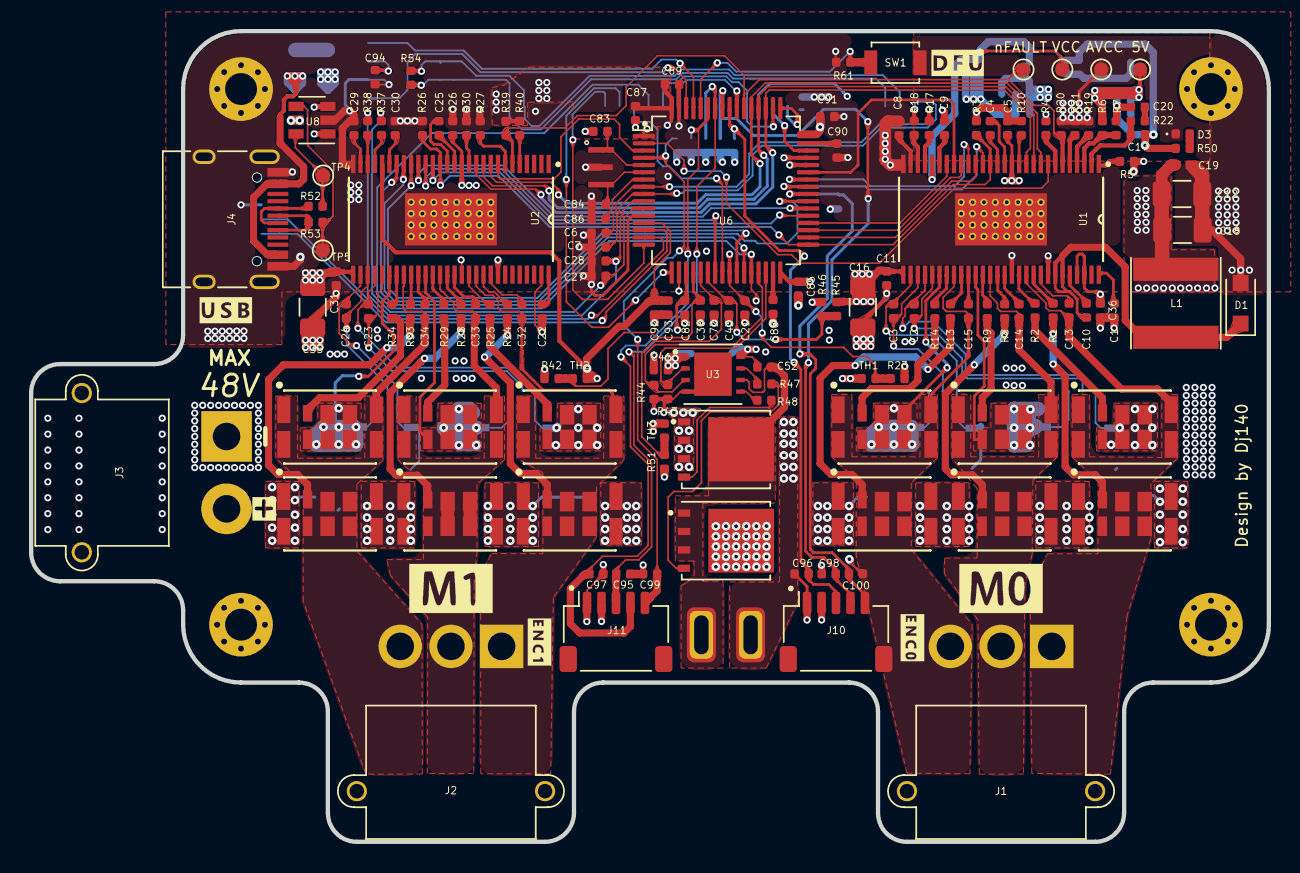
[picture p13: board bldc_motor_cntroller.kicad_pcb from above]

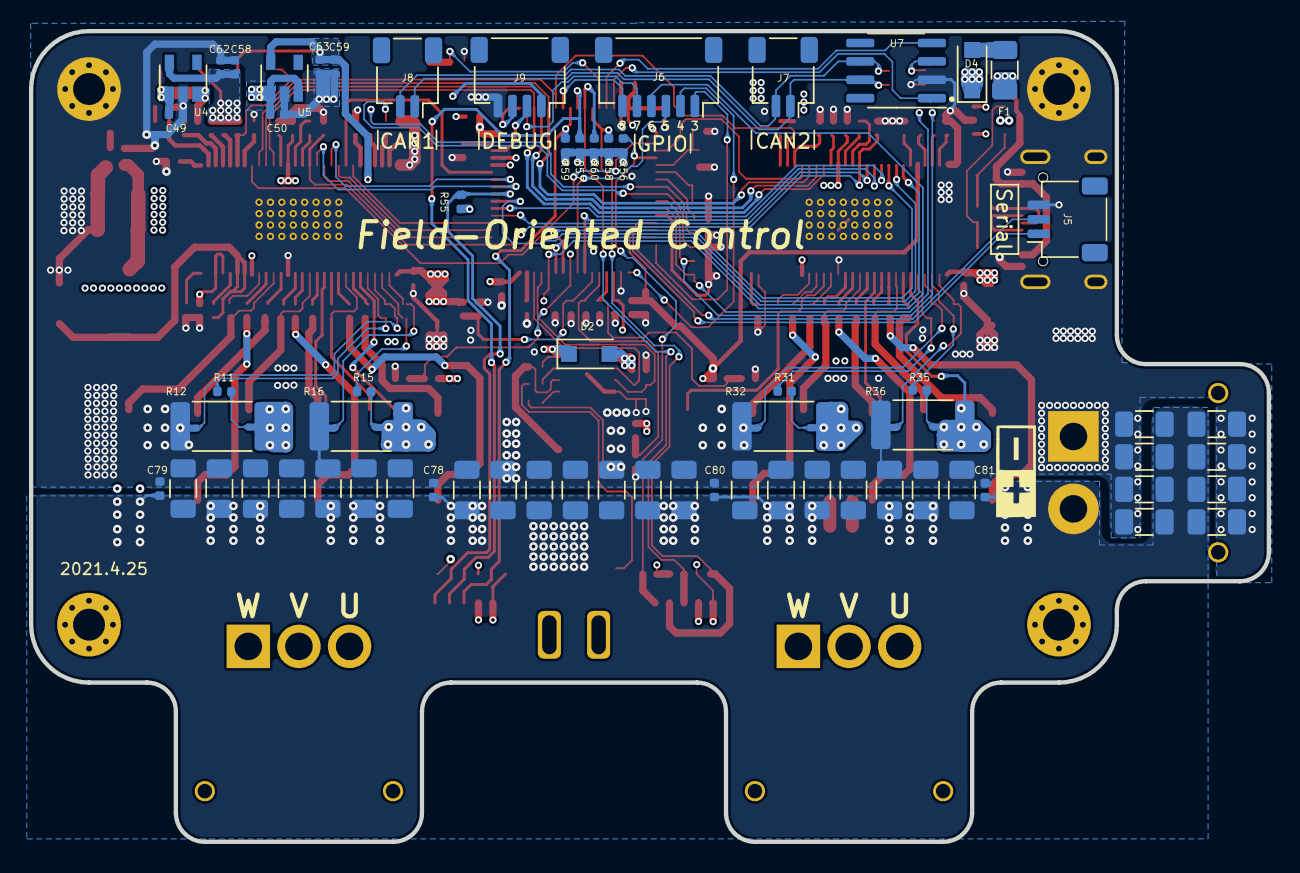
[picture p14: board bldc_motor_cntroller.kicad_pcb from below]

Board: 4 copper layers, 85.5 x 56.0 mm, 222 parts (72 on the bottom side), 155 nets.

Parts:
C1, C22: 15nF 50V; C_0402_1005Metric
C2, C3, C6, C7, C23, C24, C27, C28: 2.2nF 50V; C_0402_1005Metric
C4, C25: 22nF 50V; C_0402_1005Metric
C5, C21, C26, C38, C41: 2.2uF 25V; C_0402_1005Metric
C8, C9, C19, C29, C30, C49, C50, C58, C59, C93: 1uF 25V; C_0402_1005Metric
C10, C11, C13, C14, C15, C31, C36, C52, C78, C79, C80, C81: 100nF 50V; C_0402_1005Metric
C12, C18: 47uF 16V; C_1206_3216Metric
C16, C35: 4.7uF 50V; C_1206_3216Metric
C17: 82pF 50V; C_0402_1005Metric
C20, C43: 270pF 50V; C_0402_1005Metric
C32, C33, C34: 0.1uF 50V; C_0402_1005Metric
C39, C40, C42, C44, C45, C46, C47, C48, C51, C53, C54, C55, C56, C57, C60, C61, C64, C65, C66, C67, C68, C69, C70, C71, C73, C74, C75, C76, C77: 100uF 50V; C_1206_3216Metric
C62, C63: 0.1uF 16V; C_0402_1005Metric
C72, C88, C90: 2.2uF 16V; C_0402_1005Metric
C82, C85, C87, C89, C91, C92, C94, C95, C96, C97, C98, C99, C100: 100nF; C_0402_1005Metric
C83, C84: 12pF; C_0402_1005Metric
C86: 100nF 16V; C_0402_1005Metric
D1: 100V 2A SMB; D_SOD-123F
D2: MBR140SFT1G; D_SOD-123F
D3: GREEN; LED_0402_1005Metric
D4: MBR2H100SFT3G; D_SOD-123F
F1: Fuse_500MA; Fuse_1206_3216Metric
H1, H2, H3, H4: MountingHole_Pad; MountingHole_2.2mm_M2_Pad_Via
H5, H6: MountingHole_Pad; TestPoint_Round
J1, J2: MR30PW-M 15A (30A); AMASS_MR30PW-M_1x03_P3.50mm_Horizontal
J3: XT30; AMASS_XT30PW-M_1x02_P2.50mm_Horizontal
J4: USB_C_Receptacle_USB2.0; USB_C_Receptacle_HRO_TYPE-C-31-M-12
J5: Conn_01x03; JST_SH_SM03B-SRSS-TB_1x03-1MP_P1.00mm_Horizontal
J6: Conn_01x06; JST_SH_SM06B-SRSS-TB_1x06-1MP_P1.00mm_Horizontal
J7, J8: Conn_01x02; JST_SH_SM02B-SRSS-TB_1x02-1MP_P1.00mm_Horizontal
J9: Conn_01x04; JST_SH_SM04B-SRSS-TB_1x04-1MP_P1.00mm_Horizontal
J10, J11: Conn_01x05; JST_SH_SM05B-SRSS-TB_1x05-1MP_P1.00mm_Horizontal
L1: 33uH 1.4A; L_Taiyo-Yuden_NR-60xx
NT1, NT2, NT3, NT4, NT5, NT6, NT7, NT8: Net-Tie_2; NetTie-2_SMD_Pad0.5mm
Q1, Q2, Q3, Q4, Q5, Q6, Q7, Q8, Q9, Q10, Q11, Q12: IRF7480MTRPBF; Infineon-MG-WDSON-8-05_2016-901-MFG
Q13, Q14: CSD18540Q5B; TDSON-8-1
R1, R2, R8, R9, R13, R14, R24, R25, R28, R29, R33, R34, R47, R48: 2R2; R_0402_1005Metric
R3, R26, R46, R50: 1k; R_0402_1005Metric
R4, R6, R27, R45: 18k; R_0402_1005Metric
R5: 220k 1%; R_0402_1005Metric
R7, R10, R23, R30, R42, R43, R44, R51, R55, R56, R57, R58, R59, R60: 3.3k; R_0402_1005Metric
R11, R15, R31, R35, R54: 120R; R_0402_1005Metric
R12, R16, R32, R36: 500uOhm 6W 1%; R_2512_6332Metric
R17, R18, R37, R38, R52, R53: 22R 1%; R_0402_1005Metric
R19, R20, R21, R39, R40, R61: 10k; R_0402_1005Metric
R22: 47k 1%; R_0402_1005Metric
SW1: B3U-1000P-B; SW_SPST_B3U-1000P
TH1, TH2, TH3: 10k; R_0402_1005Metric
TP1, TP2, TP3, TP4, TP5, TP6: TestPoint; TestPoint_Pad_D1.0mm
U1, U2: DRV8301DCAR; DRV8301DCA
U3: LM5109BSD; WSON-8_4x4mm_P0.8mm
U4: SPX3819M5-L-3-3; SOT-23-5
U5: LP5907MFX-3.3; SOT-23-5
U6: STM32F405RGTx; LQFP-64_10x10mm_P0.5mm
U7: SN65HVD232; SOIC-8_3.9x4.9mm_P1.27mm
U8: USBLC6-2SC6; SOT-23-6
Y1: Crystal_GND3_Small; CSTCE8M00G55-R0

Connections:
+3.3VA: C59.1, C63.1, C92.1, C93.1, TH1.1, TH2.1, TH3.1, TP3.1, U1.24, U2.24, U5.5, U6.13
+3V3: C58.1, C62.1, C82.1, C85.1, C87.1, C89.1, C91.1, C94.2, D3.1, R19.2, R20.2, R21.2, R39.2, R40.2, R55.1, R56.1, R57.1, R58.1, R59.1, R60.1, SW1.1, TP2.1, U1.49, U2.49, U4.5, U6.1, U6.19, U6.32, U6.48, U6.64, U7.3
+5V: C12.1, C18.1, C19.1, C49.1, C50.1, D4.1, J9.1, J10.2, J11.2, L1.2, R6.2, TP1.1, U4.1, U4.3, U5.1, U5.3, U8.5
/I/O Interface/BOOT0: R61.2, SW1.2, U6.60
/I/O Interface/CAN_D: U6.62, U7.1
/I/O Interface/CAN_R: U6.61, U7.4
/I/O Interface/DEBUG_SWCLK: J9.3, U6.49
/I/O Interface/DEBUG_SWDIO: J9.2, U6.46
/I/O Interface/ENC0_A: C96.2, J10.3, R59.2, U6.56
/I/O Interface/ENC0_B: C98.2, J10.4, R57.2, U6.57
/I/O Interface/ENC0_Z: C100.2, J10.5, R55.2, U6.40
/I/O Interface/ENC1_A: C95.2, J11.3, R60.2, U6.58
/I/O Interface/ENC1_B: C97.2, J11.4, R58.2, U6.59
/I/O Interface/ENC1_Z: C99.2, J11.5, R56.2, U6.4
/I/O Interface/GPIO_1: J5.1, U6.14
/I/O Interface/GPIO_2: J5.2, U6.15
/I/O Interface/GPIO_3: J6.1, U6.16
/I/O Interface/GPIO_4: J6.2, U6.17
/I/O Interface/GPIO_5: J6.3, U6.24
/I/O Interface/GPIO_6: J6.4, U6.28
/I/O Interface/GPIO_7: J6.5, U6.50
/I/O Interface/GPIO_8: J6.6, U6.55
/I/O Interface/USB_D+: R53.1, TP5.1, U8.4
/I/O Interface/USB_D-: R52.1, TP4.1, U8.6
/I/O Interface/USB_DN: U6.44, U8.1
/I/O Interface/USB_DP: U6.45, U8.3
/Microcontroller Interface/AUX_H: R43.2, U3.2, U6.30
/Microcontroller Interface/AUX_L: R44.2, U3.3, U6.29
/Microcontroller Interface/AUX_TEMP: C72.1, R51.2, TH3.2, U6.21
/Microcontroller Interface/EN_GATE: R3.2, R26.2, U1.16, U2.16, U6.33
/Microcontroller Interface/M0_AH: U1.17, U6.41
/Microcontroller Interface/M0_AL: U1.18, U6.34
/Microcontroller Interface/M0_BH: U1.19, U6.42
/Microcontroller Interface/M0_BL: U1.20, U6.35
/Microcontroller Interface/M0_CH: U1.21, U6.43
/Microcontroller Interface/M0_CL: U1.22, U6.36
/Microcontroller Interface/M0_TEMP: C21.1, R23.2, TH1.2, U6.25
/Microcontroller Interface/M1_AH: U2.17, U6.37
/Microcontroller Interface/M1_AL: U2.18, U6.23
/Microcontroller Interface/M1_BH: U2.19, U6.38
/Microcontroller Interface/M1_BL: U2.20, U6.26
/Microcontroller Interface/M1_CH: U2.21, U6.39
/Microcontroller Interface/M1_CL: U2.22, U6.27
/Microcontroller Interface/M1_TEMP: C38.1, R42.2, TH2.2, U6.20
/Microcontroller Interface/SPI_M0_nCS: U1.8, U6.2
/Microcontroller Interface/SPI_M1_nCS: U2.8, U6.3
/Microcontroller Interface/SPI_MISO: U1.10, U2.10, U6.52
/Microcontroller Interface/SPI_MOSI: U1.9, U2.9, U6.53
/Microcontroller Interface/SPI_SCK: U1.11, U2.11, U6.51
/Microcontroller Interface/VBUS_S: C43.1, R45.2, R46.1, U6.22
/Microcontroller Interface/nFAULT: R20.1, R39.1, TP6.1, U1.6, U2.6, U6.54
/Motor Driver/AVDD: C8.1, U1.27
/Motor Driver/CSENSE_1: C6.2, R17.2, U6.8
/Motor Driver/CSENSE_2: C7.2, R18.2, U6.9
/Motor Driver/DVDD: C9.1, U1.23
/Motor Driver/GH_A: R1.1, U1.47
/Motor Driver/GH_B: R8.1, U1.42
/Motor Driver/GH_C: R13.1, U1.37
/Motor Driver/GL_A: R2.1, U1.45
/Motor Driver/GL_B: R9.1, U1.40
/Motor Driver/GL_C: R14.1, U1.35
/Motor Driver/PWRGD: R19.1, U1.4
/Motor Driver/SH_A: C13.1, J1.1, Q1.3, Q1.4, Q1.5, Q1.6, Q1.8, Q2.1, Q2.2, Q2.9, Q2.10, U1.46
/Motor Driver/SH_B: C14.1, J1.2, Q3.3, Q3.4, Q3.5, Q3.6, Q3.8, Q4.1, Q4.2, Q4.9, Q4.10, U1.41
/Motor Driver/SH_C: C15.1, J1.3, Q5.3, Q5.4, Q5.5, Q5.6, Q5.8, Q6.1, Q6.2, Q6.9, Q6.10, U1.36
/Motor Driver/SL_B: NT1.2, Q4.3, Q4.4, Q4.5, Q4.6, Q4.8, R12.2, U1.39
/Motor Driver/SL_C: NT3.2, Q6.3, Q6.4, Q6.5, Q6.6, Q6.8, R16.2, U1.34
/Motor Driver/SN1: C2.2, R11.1, U1.33
/Motor Driver/SN2: C3.2, R15.1, U1.31
/Motor Driver/SP1: C2.1, NT2.1, U1.32
/Motor Driver/SP2: C3.1, NT4.1, U1.30
/Motor Driver/nOCTW: R21.1, U1.5
/Motor_Driver2/AVDD: C29.1, U2.27
/Motor_Driver2/CSENSE_1: C27.2, R37.2, U6.11
/Motor_Driver2/CSENSE_2: C28.2, R38.2, U6.10
/Motor_Driver2/DVDD: C30.1, U2.23
/Motor_Driver2/GH_A: R24.1, U2.47
/Motor_Driver2/GH_B: R28.1, U2.42
/Motor_Driver2/GH_C: R33.1, U2.37
/Motor_Driver2/GL_A: R25.1, U2.45
/Motor_Driver2/GL_B: R29.1, U2.40
/Motor_Driver2/GL_C: R34.1, U2.35
/Motor_Driver2/SH_A: C32.1, J2.1, Q7.3, Q7.4, Q7.5, Q7.6, Q7.8, Q8.1, Q8.2, Q8.9, Q8.10, U2.46
/Motor_Driver2/SH_B: C33.1, J2.2, Q9.3, Q9.4, Q9.5, Q9.6, Q9.8, Q10.1, Q10.2, Q10.9, Q10.10, U2.41
/Motor_Driver2/SH_C: C34.1, J2.3, Q11.3, Q11.4, Q11.5, Q11.6, Q11.8, Q12.1, Q12.2, Q12.9, Q12.10, U2.36
/Motor_Driver2/SL_B: NT5.2, Q10.3, Q10.4, Q10.5, Q10.6, Q10.8, R32.2, U2.39
/Motor_Driver2/SL_C: NT7.2, Q12.3, Q12.4, Q12.5, Q12.6, Q12.8, R36.2, U2.34
/Motor_Driver2/SN1: C23.2, R31.1, U2.33
/Motor_Driver2/SN2: C24.2, R35.1, U2.31
/Motor_Driver2/SP1: C23.1, NT6.1, U2.32
/Motor_Driver2/SP2: C24.1, NT8.1, U2.30
/Motor_Driver2/nOCTW: R40.1, U2.5
/Power Management/HS: C52.2, H6.1, Q13.1, Q13.2, Q13.3, Q14.5, U3.6
CAN_H: J7.1, J8.1, R54.2, U7.7
CAN_L: J7.2, J8.2, R54.1, U7.6
GND: C1.1, C5.2, C6.1, C7.1, C8.2, C9.2, C11.2, C12.2, C16.2, C17.2, C18.2, C19.2, C20.2, C21.2, C22.1, C26.2, C27.1, C28.1, C29.2, C30.2, C31.2, C35.2, C36.2, C38.2, C39.2, C40.2, C41.2, C42.2, C43.2, C44.2, C45.2, C46.2, C47.2, C48.2, C49.2, C50.2, C51.2, C53.2, C54.2, C55.2, C56.2, C57.2, C58.2, C59.2, C60.2, C61.2, C62.2, C63.2, C64.2, C65.2, C66.2, C67.2, C68.2, C69.2, C70.2, C71.2, C72.2, C73.2, C74.2, C75.2, C76.2, C77.2, C78.2, C79.2, C80.2, C81.2, C82.2, C83.1, C84.1, C85.2, C86.2, C87.2, C88.2, C89.2, C90.2, C91.2, C92.2, C93.2, C94.1, C95.1, C96.1, C97.1, C98.1, C99.1, C100.1, D1.2, H1.1, H2.1, H3.1, H4.1, H5.1, J3.1, J4.A1, J4.A12, J4.B1, J4.B12, J4.S1, J5.3, J9.4, J10.1, J11.1, NT2.2, NT4.2, NT6.2, NT8.2, Q2.3, Q2.4, Q2.5, Q2.6, Q2.8, Q8.3, Q8.4, Q8.5, Q8.6, Q8.8, Q14.1, Q14.2, Q14.3, R3.1, R4.2, R5.2, R7.1, R10.1, R12.1, R16.1, R23.1, R26.1, R27.2, R30.1, R32.1, R36.1, R42.1, R43.1, R44.1, R46.2, R50.2, R51.1, R61.1, U1.28, U1.44, U1.57, U1.V, U2.28, U2.44, U2.55, U2.57, U2.V, U3.4, U3.9, U4.2, U5.2, U6.12, U6.18, U6.63, U7.2, U8.2, Y1.3
GVDD: C5.1, C26.1, C41.1, D2.2, U1.13, U2.13, U3.1
unnamed: C1.2, U1.56
unnamed: C4.1, U1.14
unnamed: C4.2, U1.15
unnamed: C10.1, D1.1, L1.1, U1.50, U1.51
unnamed: C10.2, U1.52
unnamed: C13.2, U1.48
unnamed: C14.2, U1.43
unnamed: C15.2, U1.38
unnamed: C17.1, R22.1, U1.2
unnamed: C20.1, R22.2
unnamed: C22.2, U2.56
unnamed: C25.1, U2.14
unnamed: C25.2, U2.15
unnamed: C32.2, U2.48
unnamed: C33.2, U2.43
unnamed: C34.2, U2.38
unnamed: C52.1, D2.1, U3.8
unnamed: C83.2, U6.5, Y1.1
unnamed: C84.2, U6.6, Y1.2
unnamed: C86.1, U6.7
unnamed: C88.1, U6.31
unnamed: C90.1, U6.47
unnamed: D3.2, R50.1
unnamed: D4.2, F1.2
unnamed: F1.1, J4.A4, J4.A9, J4.B4, J4.B9
unnamed: J4.A6, J4.B6, R53.2
unnamed: J4.A7, J4.B7, R52.2
unnamed: NT1.1, R11.2
unnamed: NT3.1, R15.2
unnamed: NT5.1, R31.2
unnamed: NT7.1, R35.2
unnamed: Q1.7, R1.2
unnamed: Q2.7, R2.2
unnamed: Q3.7, R8.2
unnamed: Q4.7, R9.2
unnamed: Q5.7, R13.2
unnamed: Q6.7, R14.2
unnamed: Q7.7, R24.2
unnamed: Q8.7, R25.2
unnamed: Q9.7, R28.2
unnamed: Q10.7, R29.2
unnamed: Q11.7, R33.2
unnamed: Q12.7, R34.2
unnamed: Q13.4, R47.1
unnamed: Q14.4, R48.1
unnamed: R4.1, U1.7
unnamed: R5.1, U1.1
unnamed: R6.1, R7.2, U1.3
unnamed: R10.2, U1.12
unnamed: R17.1, U1.25
unnamed: R18.1, U1.26
unnamed: R27.1, U2.7
unnamed: R30.2, U2.12
unnamed: R37.1, U2.25
unnamed: R38.1, U2.26
unnamed: R47.2, U3.7
unnamed: R48.2, U3.5
VDC: C11.1, C16.1, C31.1, C35.1, C36.1, C39.1, C40.1, C42.1, C44.1, C45.1, C46.1, C47.1, C48.1, C51.1, C53.1, C54.1, C55.1, C56.1, C57.1, C60.1, C61.1, C64.1, C65.1, C66.1, C67.1, C68.1, C69.1, C70.1, C71.1, C73.1, C74.1, C75.1, C76.1, C77.1, C78.1, C79.1, C80.1, C81.1, J3.2, Q1.1, Q1.2, Q1.9, Q1.10, Q3.1, Q3.2, Q3.9, Q3.10, Q5.1, Q5.2, Q5.9, Q5.10, Q7.1, Q7.2, Q7.9, Q7.10, Q9.1, Q9.2, Q9.9, Q9.10, Q11.1, Q11.2, Q11.9, Q11.10, Q13.5, R45.1, U1.29, U1.53, U1.54, U2.29
