Agroecology-Lab/Open_drive/(commit log)

2026-01-03 Added recent JLC production files
    Untested as yet
    [bom_final_v3.csv, designators.csv, positions.csv]
2026-01-03 Added images of board
2026-01-04 PDF schematic
2026-10-25 Update to kicad 10
2026-10-25 Kicad 10
2026-10-25 48V components
